pmehrabi/HARE/controller/PCB/20150909_173246.jpg

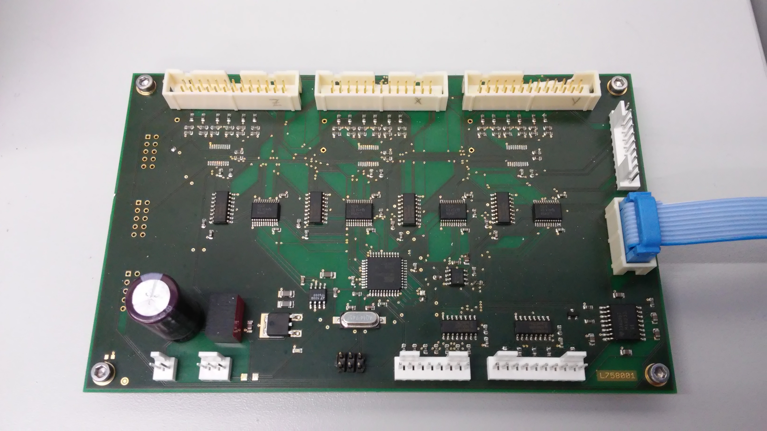
controller/PCB/20150909_173246.jpg
