pmehrabi/HARE/README-Description.md

# HARE

Hardware

PCB layout and schematics: CadSoft EAGLE 7.5.0, now Autodesk

Microcontroller: Atmel Corp, ATxmega128A4U

Firmware programming: Atmel Corp., Atmel Studio 6.2

Delay generator: Stanford Research DG645

Sample positioning: SmarAct GmbH, 3-axes SLC series, controller SDC2-3C-EUR-TAB

GUI

National Instruments LabVIEW 2015, SP1 

Additional Package:

Asynchronous Message Communication (AMC) Library, available at jki.net/vipm

VI Package Manager 2014
