pmehrabi/HARE/controller/cable HD26 to D25/SCBD1508-00-sch.pdf

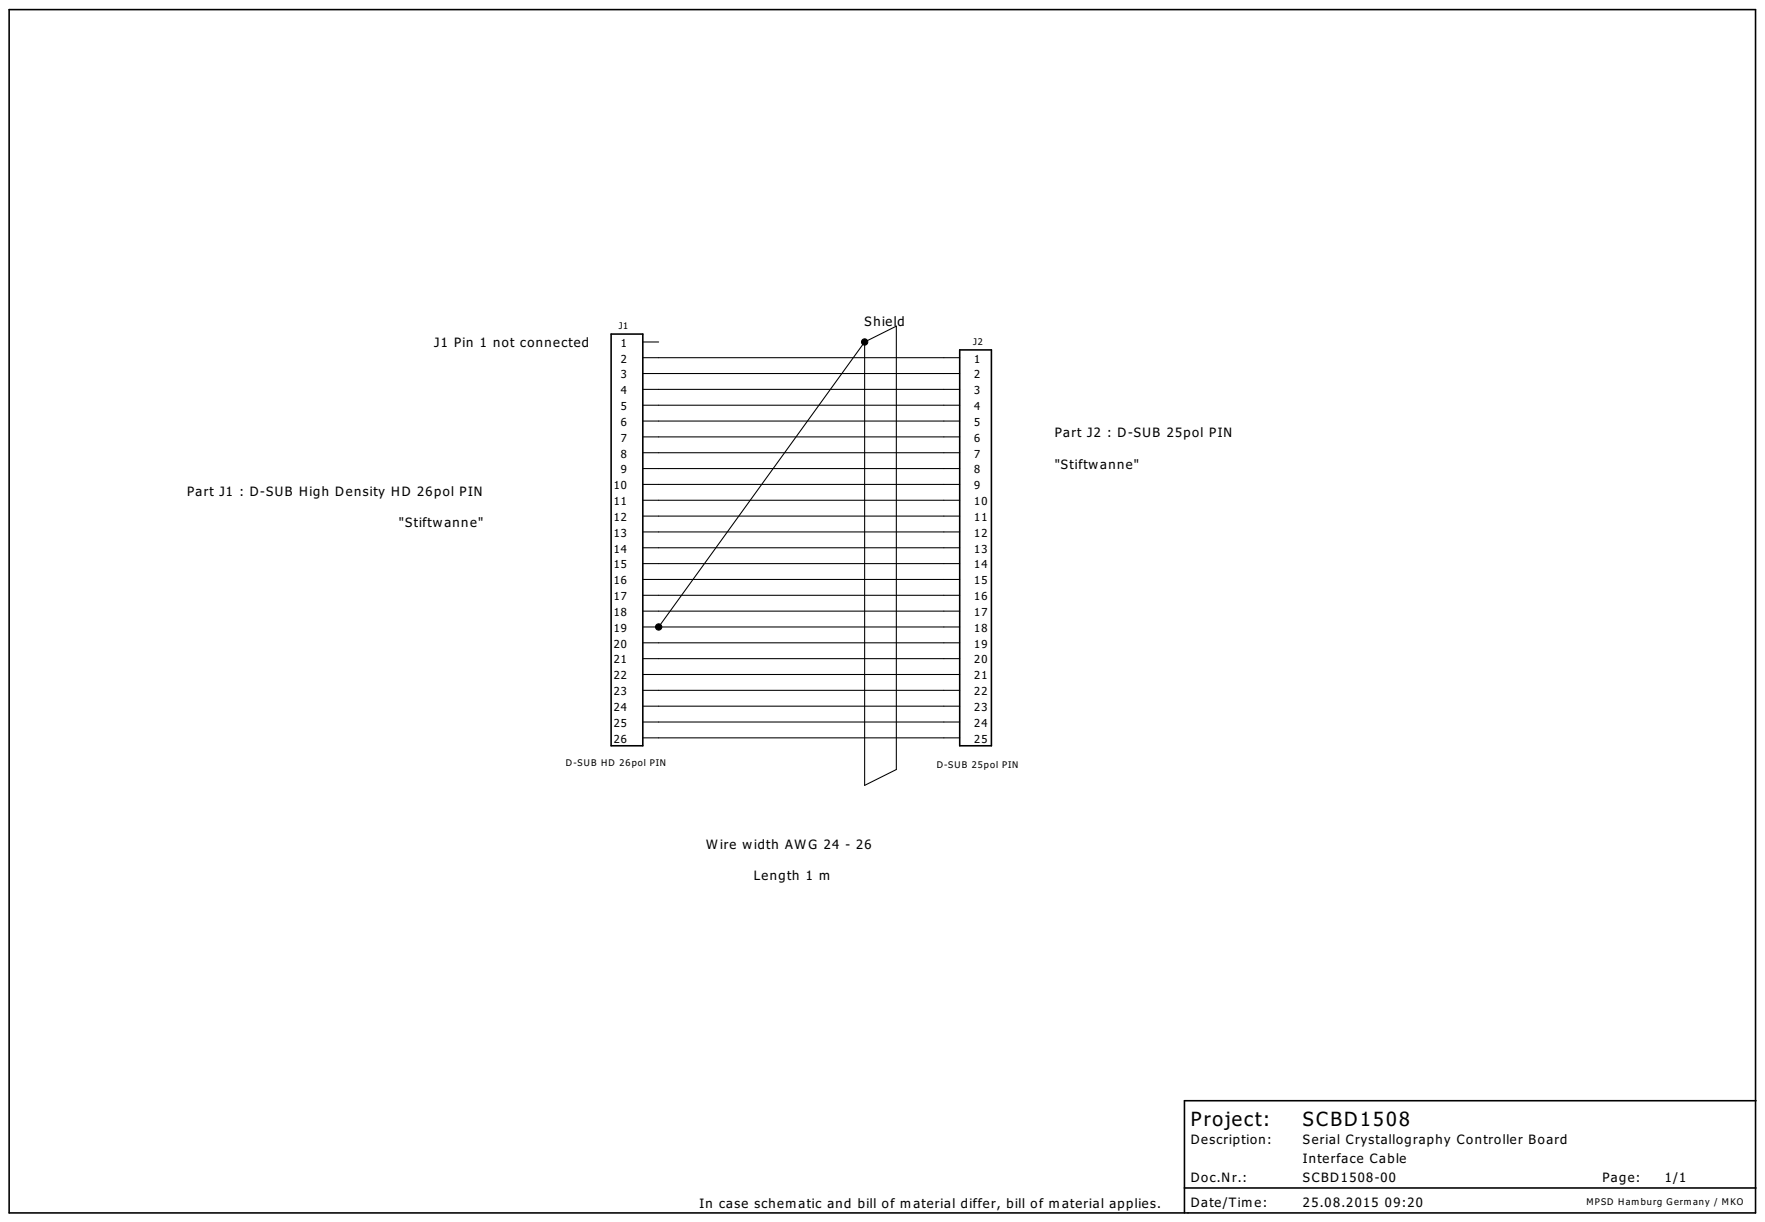
[picture p4: page 1]

Part J1 : D-SUB High Density HD 26pol PIN
