pmehrabi/HARE/controller/PCB/SCCB1508-00-sch.pdf

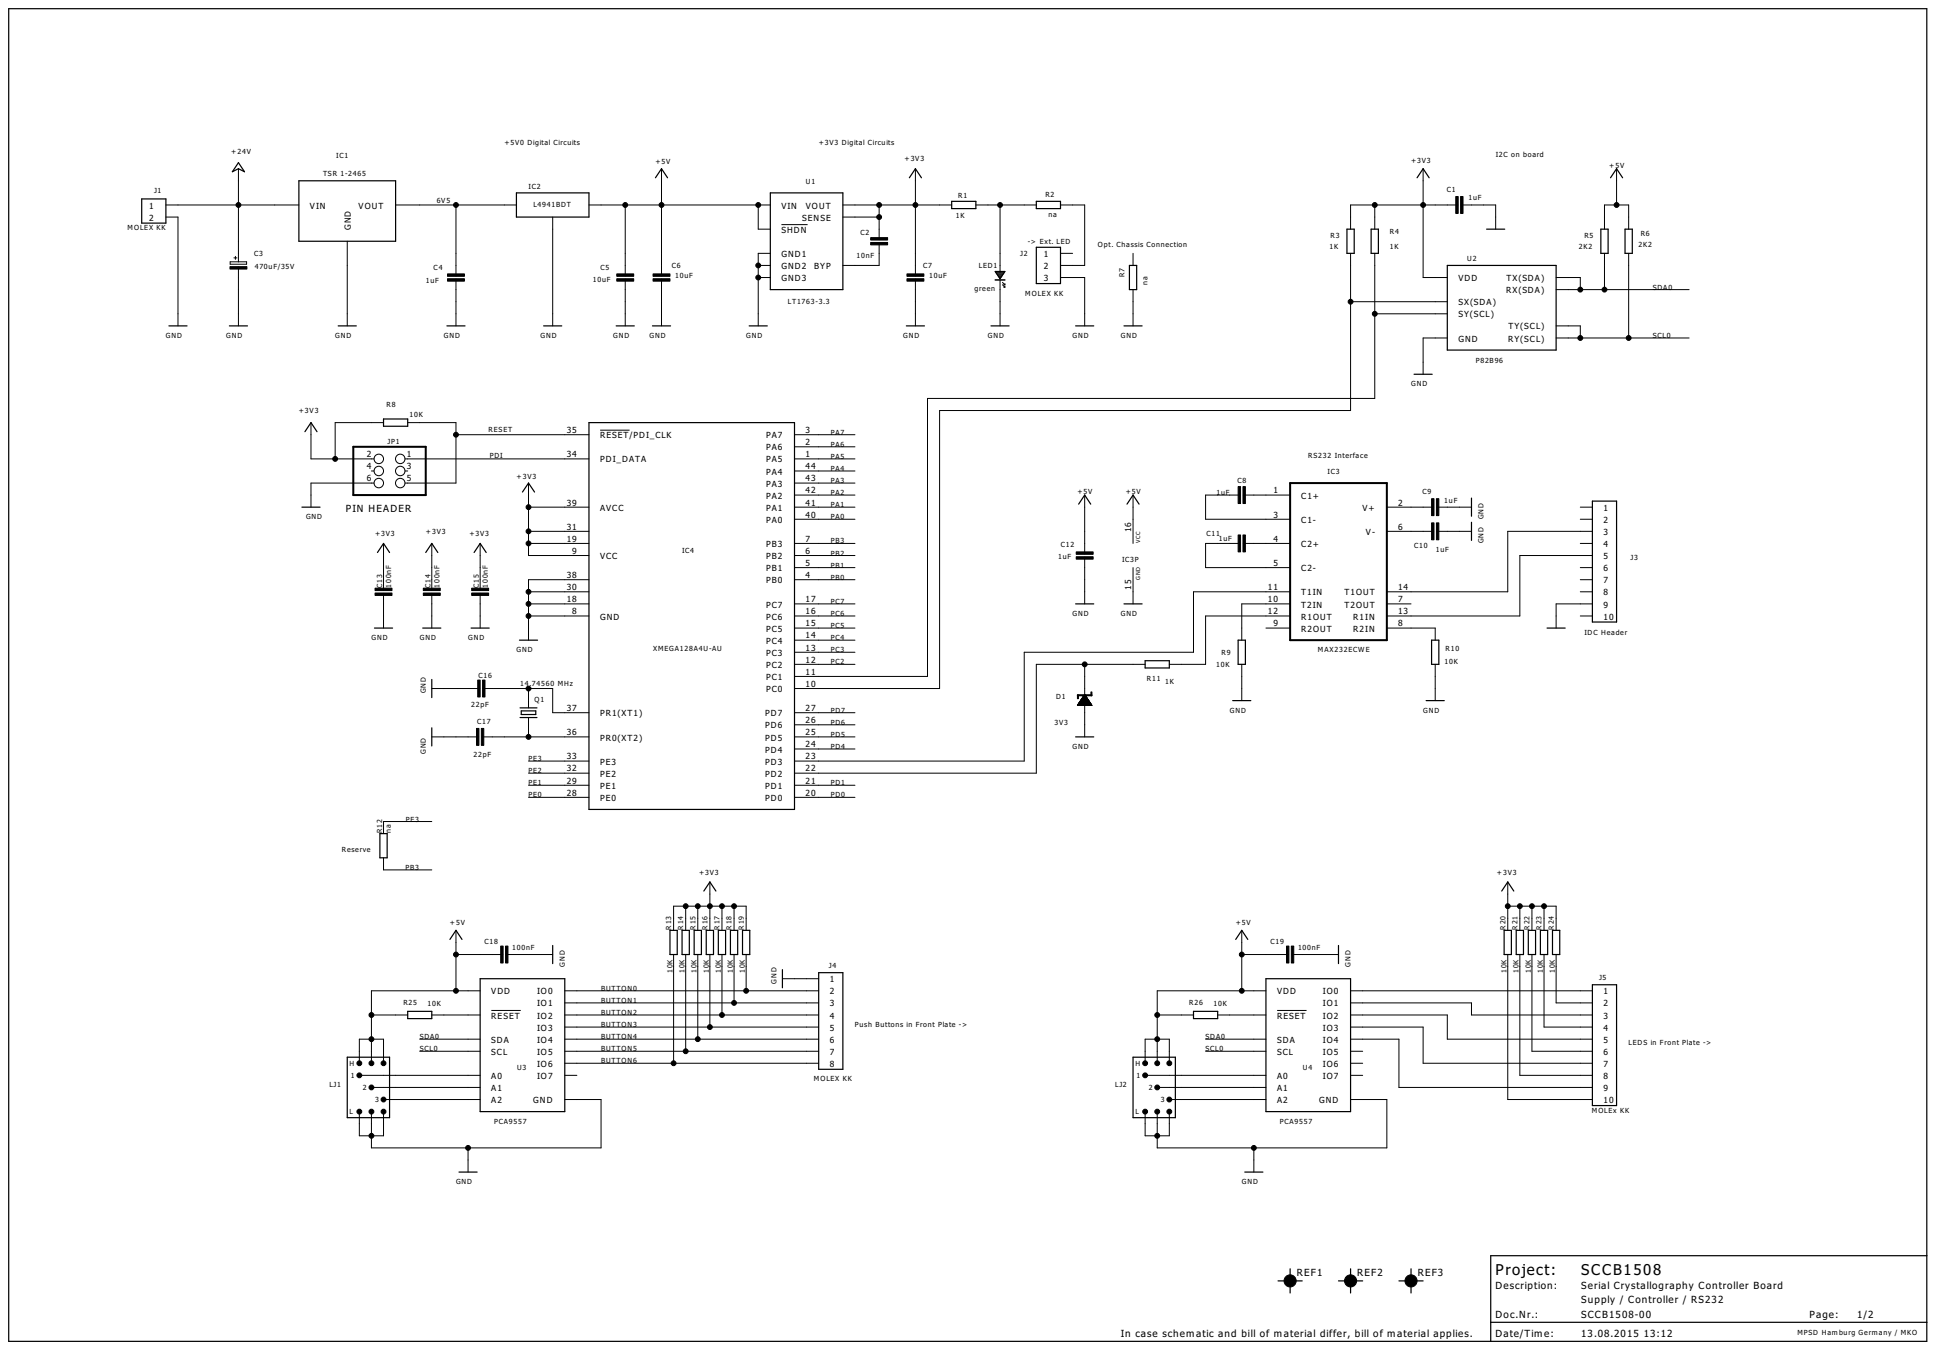
[picture p5: page 1]

Push Buttons in Front Plate ->

LEDS in Front Plate ->

Serial Crystallography Controller Board SCCB1508-00

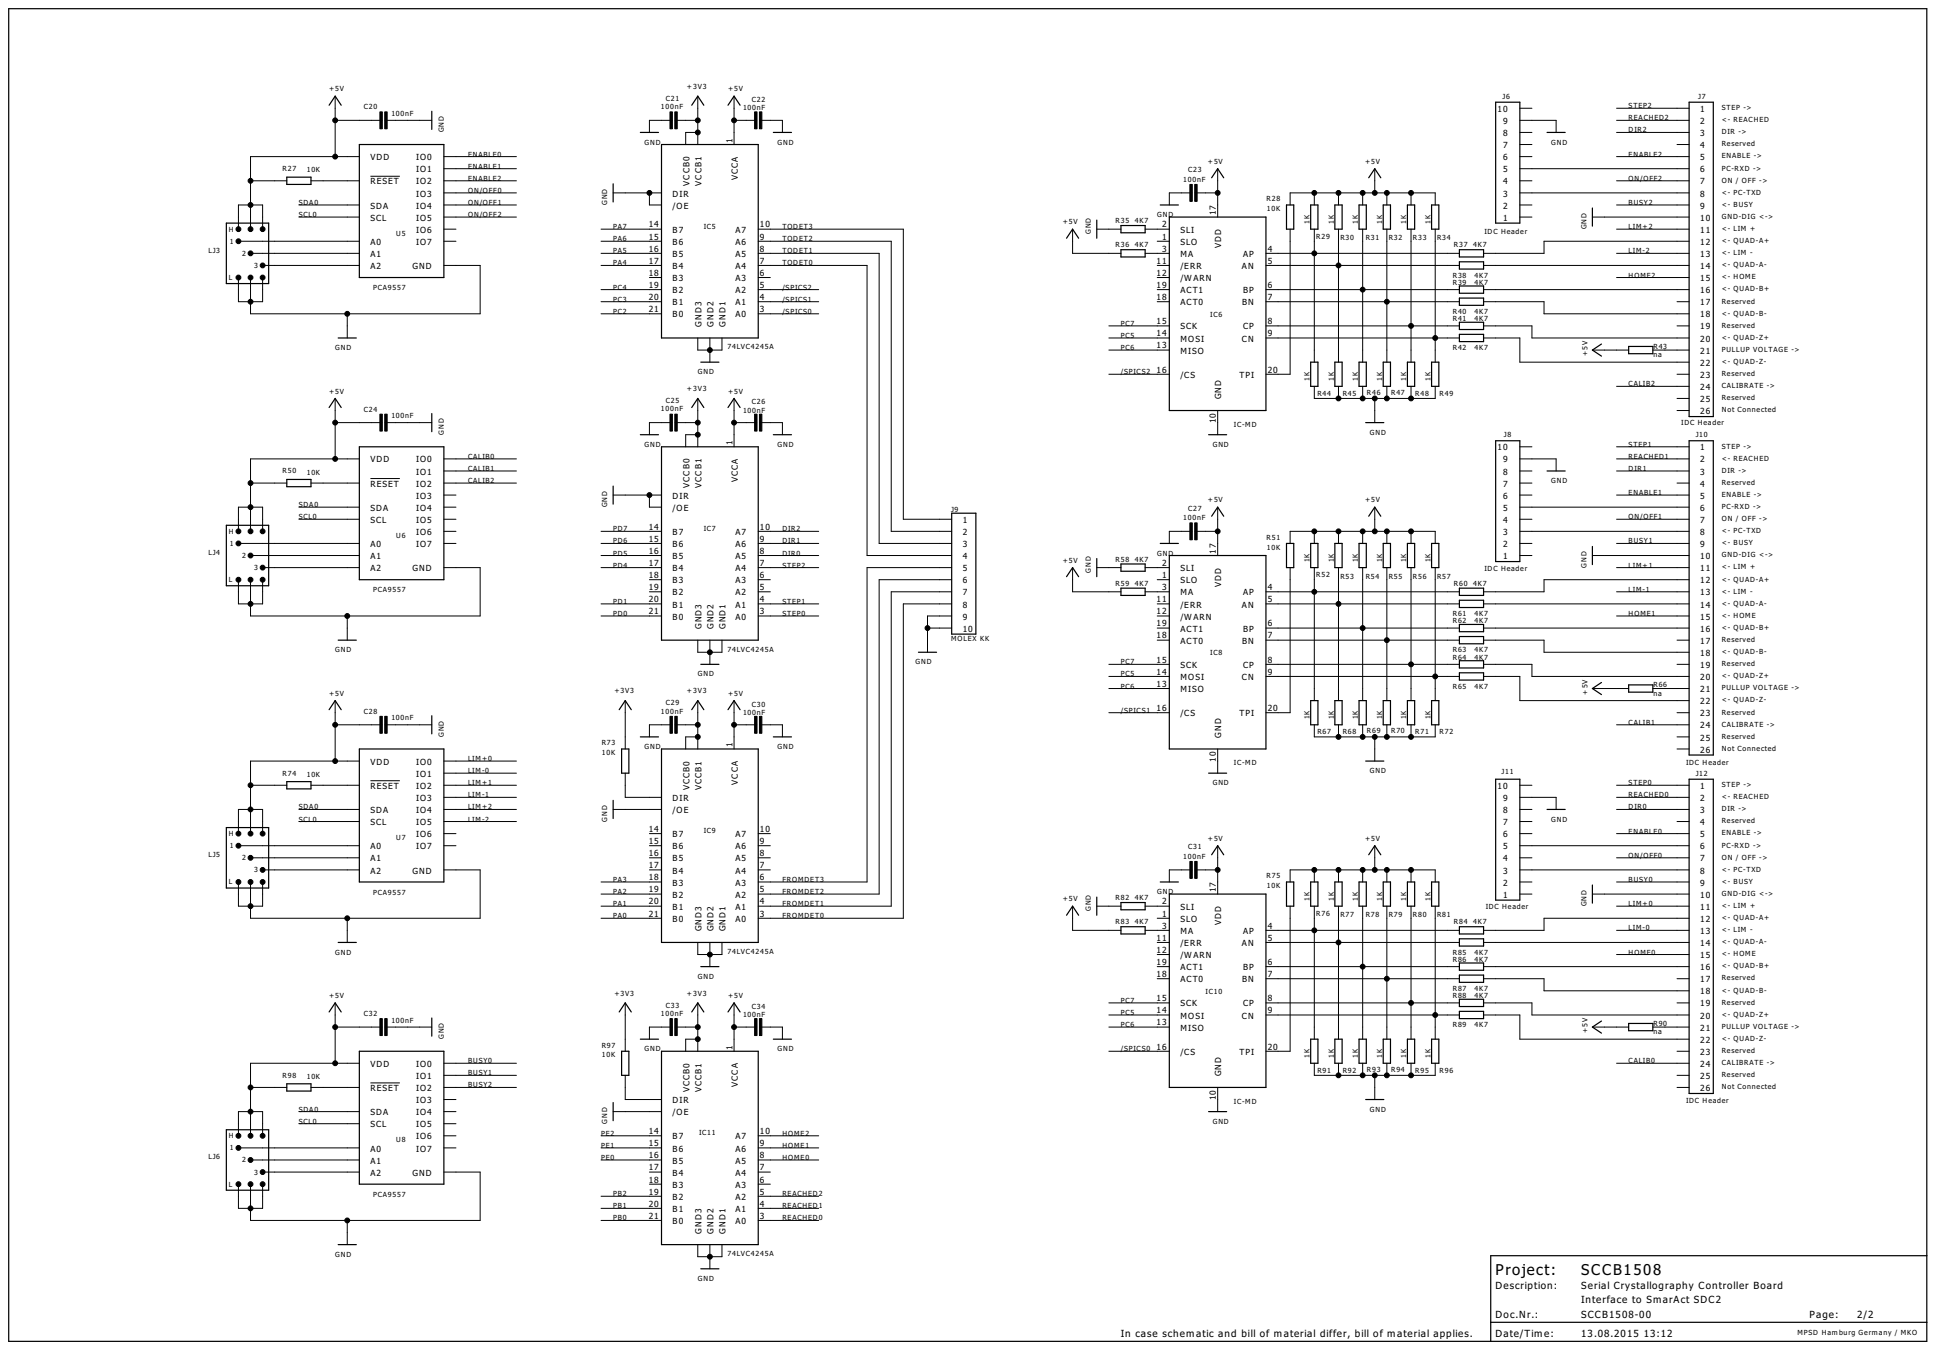
[picture p6: page 2]
