pmehrabi/HARE/controller/PCB/SCCB1508-00-brdo.pdf

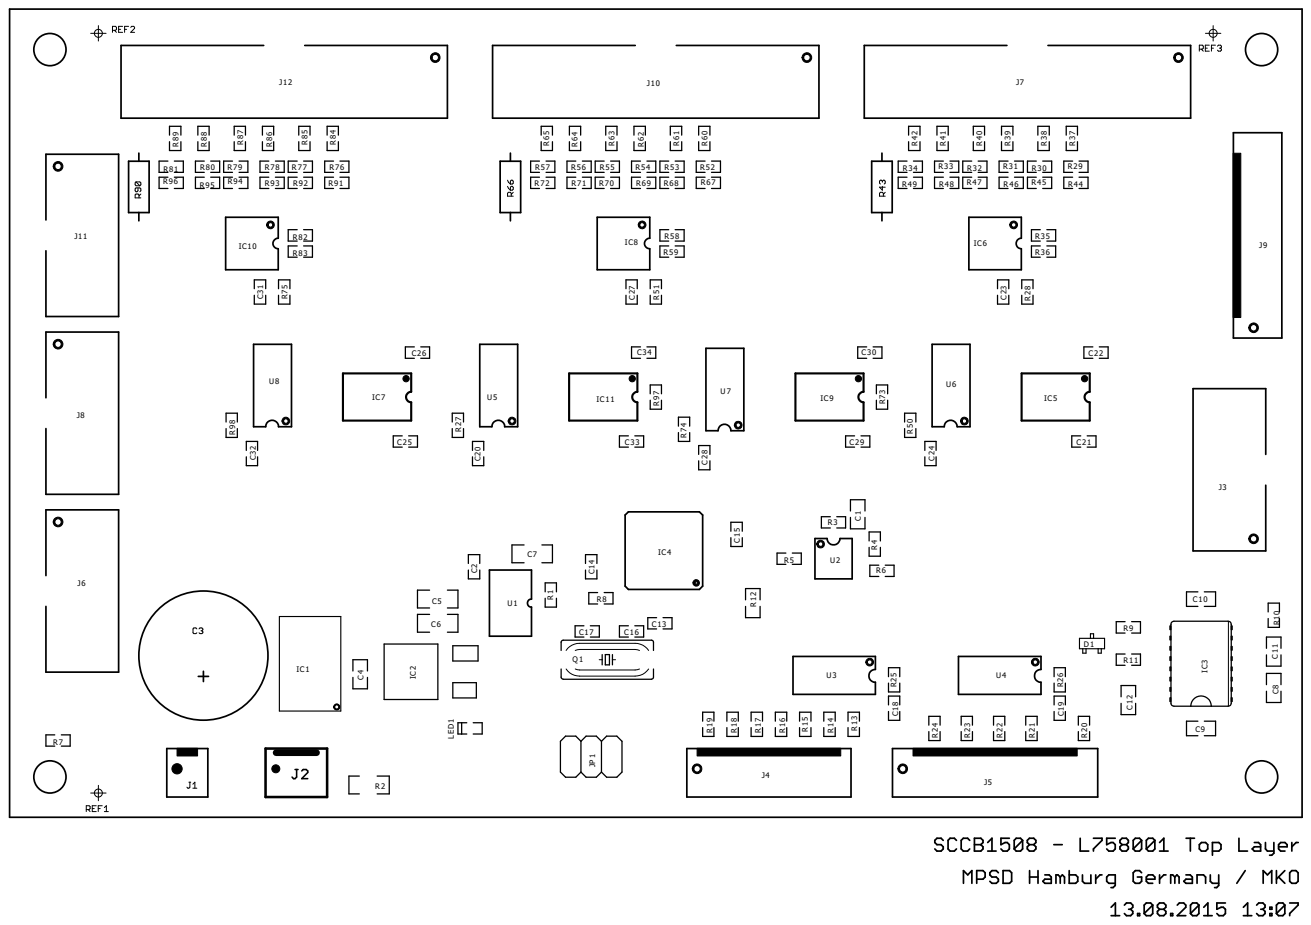
[picture p7: page 1]
