pmehrabi/HARE/controller/PCB/SCCB1508-00.brd

## EAGLE design controller/PCB/SCCB1508-00.brd (2018-08-08)

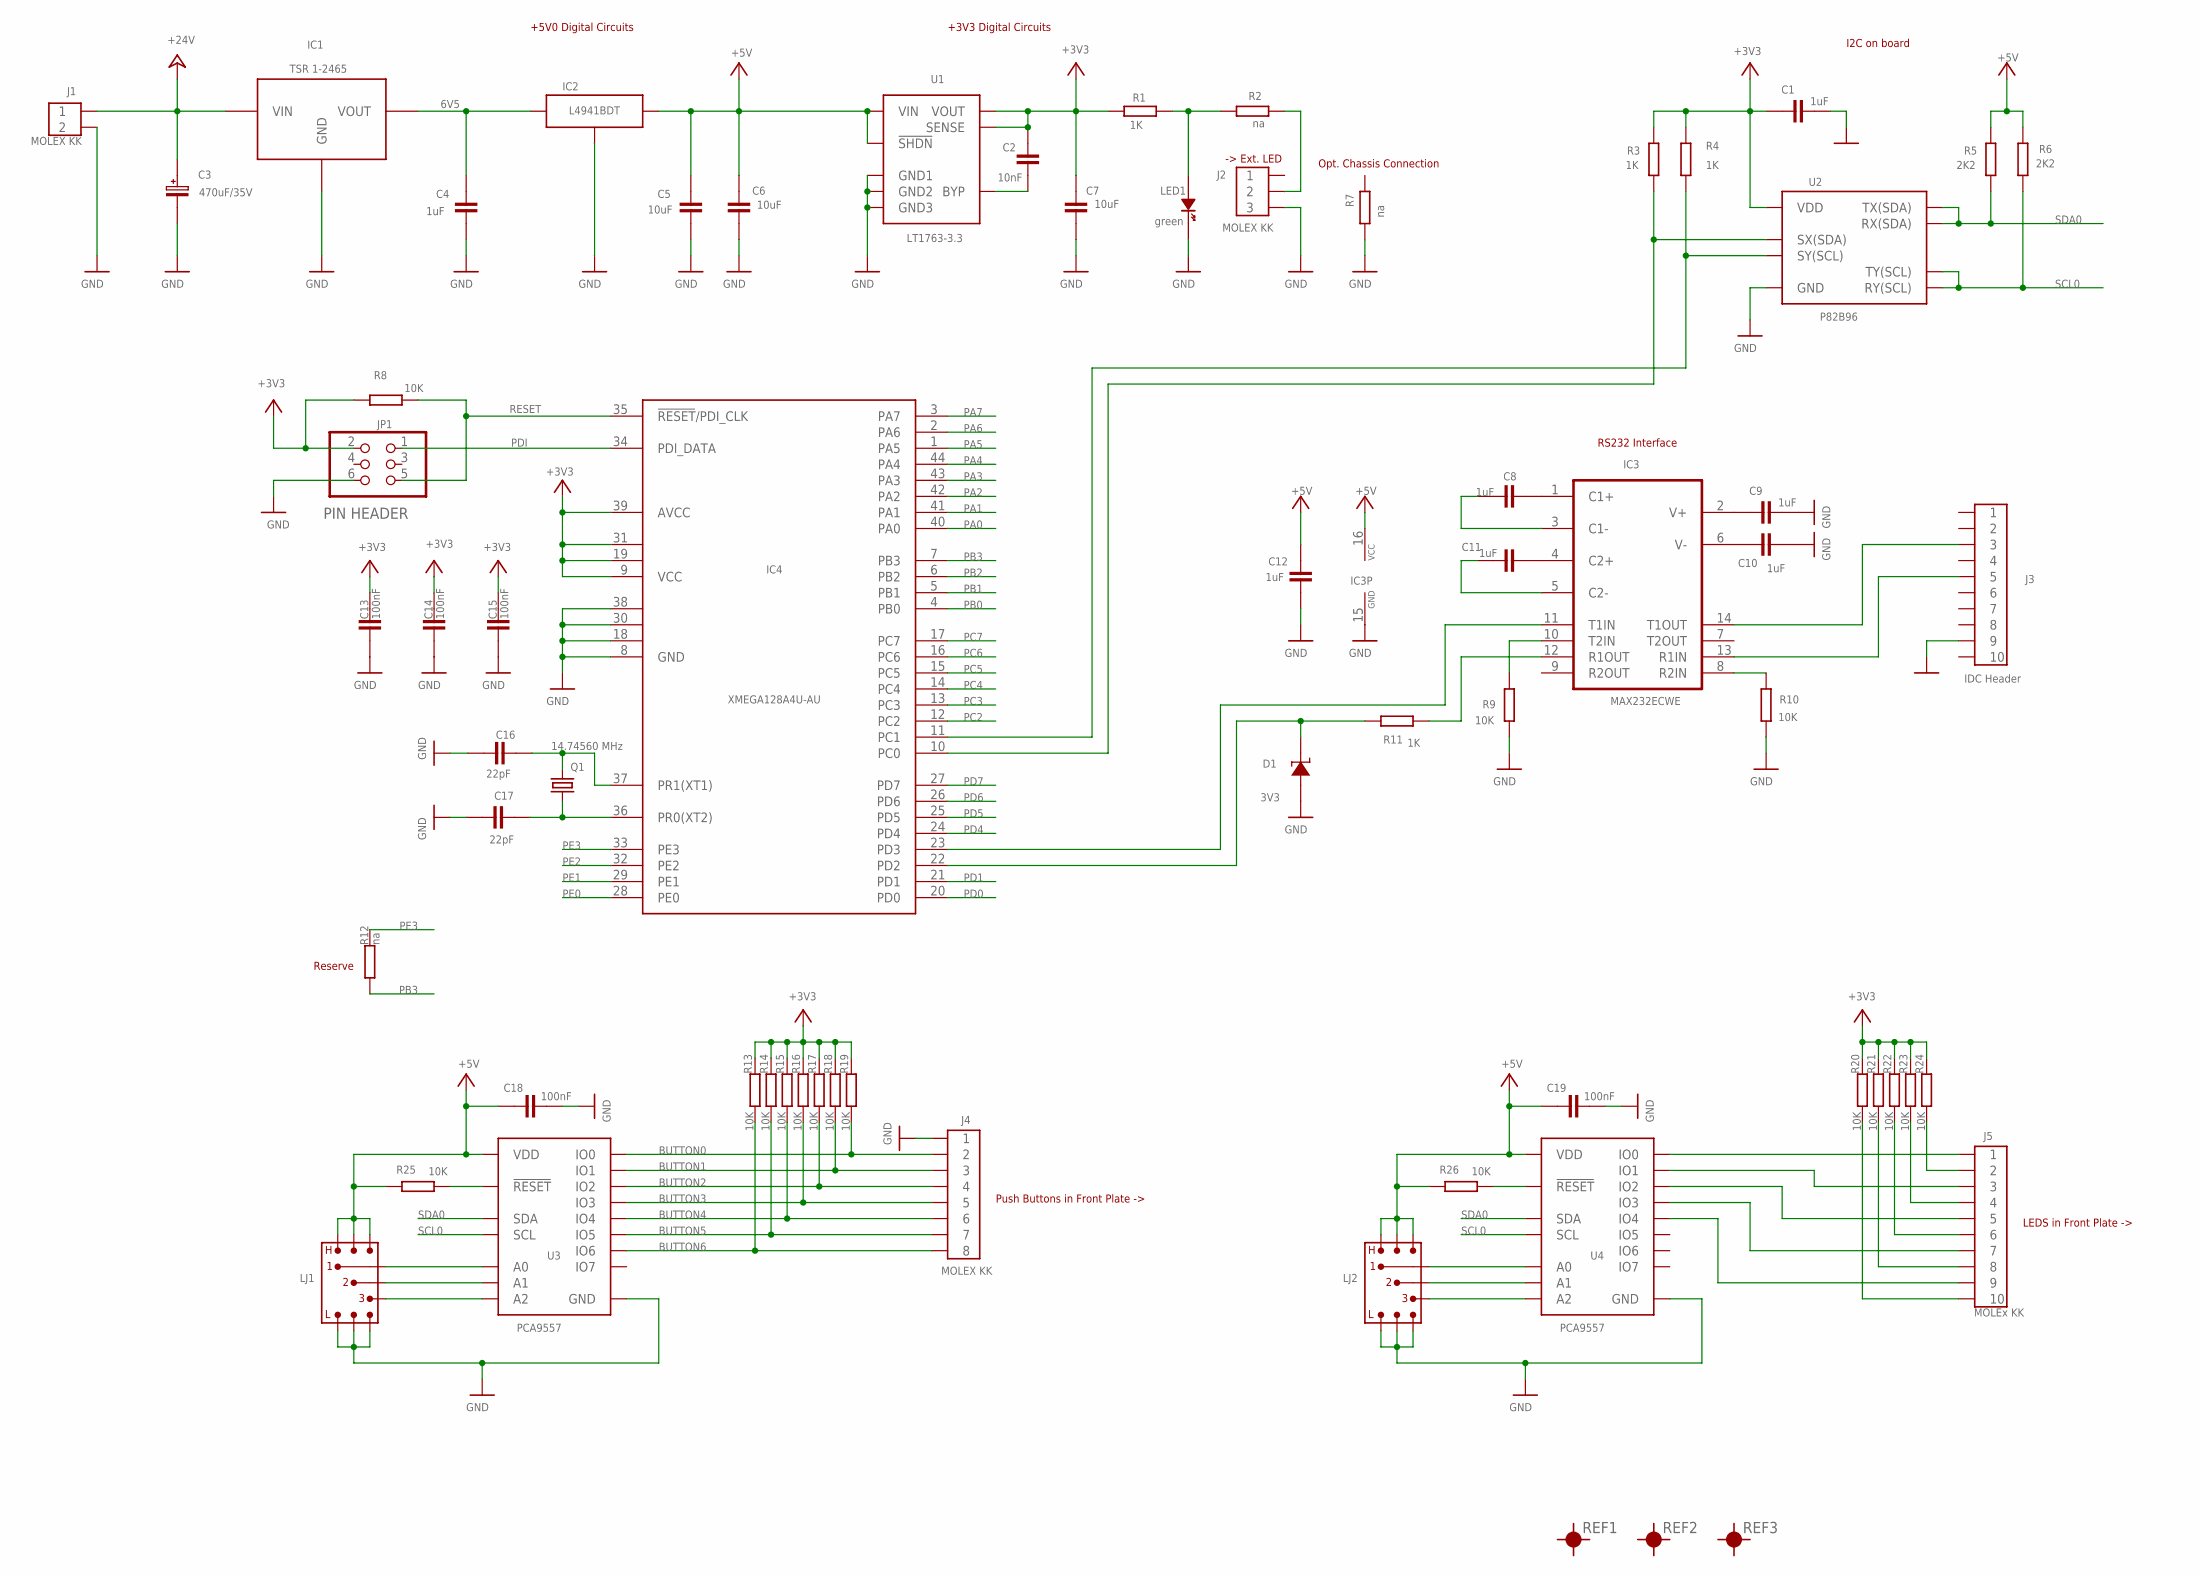
[picture p8: schematic SCCB1508-00.sch, sheet 1]

Parts:
C1, C4, C8, C9, C10, C11, C12: 1uF; 0805
C2: 10nF; 0603
C3: 470uF/35V; C_POL_RM5_D16
C5, C6, C7: 10uF; 1206
C13, C14, C15, C18, C19: 100nF; 0603
C16, C17: 22pF; 0603
D1: 3V3; SOT_23
IC1: TSR 1-2465; TRACO_TSR_1
IC2: L4941BDT; D_PAK
IC3: MAX232ECWE; SO16L
IC4: XMEGA128A4U-AU; TQFP44
J1: MOLEX KK; MOLEX_KK_02POL
J2: MOLEX KK; MOLEX_KK_03POL
J3: IDC Header; IDC_WANNE_10POL
J4: MOLEX KK; MOLEX_KK_08POL
J5: MOLEx KK; MOLEX_KK_10POL
JP1: PIN HEADER; 2X03
LED1: green; 0603_POL
LJ1, LJ2: LOETJUMPER_3KHL_; LOETJUMPER_3KHL
Q1: 14.74560 MHz; HC49UP
R1, R3, R4, R11: 1K; 0603
R2: na; 1206
R5, R6: 2K2; 0603
R7: na; 0603
R8, R9, R10, R13, R14, R15, R16, R17, R18, R19, R20, R21, R22, R23, R24, R25, R26: 10K; 0603
R12: na; 0805
REF1, REF2, REF3: PASSERMARKE_1.0; PASSERMARKE_01
U1: LT1763-3.3; SOIC127P-6-8POL
U2: P82B96; SO_8_BW3.9MM
U3, U4: PCA9557; SO_16_BW3.9MM

Connections:
6V5: C4.2, IC1.P$3 (VOUT), IC2.1 (IN)
+3V3: C1.1, C2.2, C7.2, C13.2, C14.2, C15.2, IC4.9 (VCC), IC4.19 (VCC1), IC4.31 (VCC2), IC4.39 (AVCC), JP1.2, R1.2, R3.1, R4.1, R8.1, R13.1, R14.1, R15.1, R16.1, R17.1, R18.1, R19.1, R20.1, R21.1, R22.1, R23.1, R24.1, U1.1 (VOUT), U1.2 (SENSE), U2.8 (VDD); also elsewhere on the board
+5V: C5.2, C6.2, C12.2, C18.2, C19.2, IC2.3 (OUT), IC3.16 (VCC), LJ1.H1, LJ1.H2, LJ1.H3, LJ2.H1, LJ2.H2, LJ2.H3, R5.1, R6.1, R25.2, R26.2, U1.5 (!SHDN), U1.8 (VIN), U3.16 (VDD), U4.16 (VDD); also elsewhere on the board
+24V: C3.1 (PLUS), IC1.P$1 (VIN), J1.P$1 (1)
BUTTON0: J4.P$2 (2), R19.2, U3.6 (IO0)
BUTTON1: J4.P$3 (3), R18.2, U3.7 (IO1)
BUTTON2: J4.P$4 (4), R17.2, U3.9 (IO2)
BUTTON3: J4.P$5 (5), R16.2, U3.10 (IO3)
BUTTON4: J4.P$6 (6), R15.2, U3.11 (IO4)
BUTTON5: J4.P$7 (7), R14.2, U3.12 (IO5)
BUTTON6: J4.P$8 (8), R13.2, U3.13 (IO6)
GND: C1.2, C3.2 (MINUS), C4.1, C5.1, C6.1, C7.1, C9.2, C10.2, C12.1, C13.1, C14.1, C15.1, C16.1, C17.1, C18.1, C19.1, D1.1 (ANODE), IC1.P$2 (GND), IC2.2 (GND), IC3.15 (GND), IC4.8 (GND), IC4.18 (GND1), IC4.30 (GND2), IC4.38 (GND3), J1.P$2 (2), J2.P$3 (3), J3.9, J4.P$1 (1), JP1.6, LED1.1 (KATHODE), LJ1.L1, LJ1.L2, LJ1.L3, LJ2.L1, LJ2.L2, LJ2.L3, R7.2, R9.1, R10.1, U1.3 (GND1), U1.6 (GND2), U1.7 (GND3), U2.4 (GND), U3.8 (GND), U4.8 (GND); also elsewhere on the board
unnamed: C8.1, IC3.1 (C1+)
unnamed: IC3.14 (T1OUT), J3.3
unnamed: C9.1, IC3.2 (V+)
unnamed: IC3.10 (T2IN), R9.2
unnamed: C10.1, IC3.6 (V-)
unnamed: C11.1, IC3.4 (C2+)
unnamed: C8.2, IC3.3 (C1-)
unnamed: IC3.8 (R2IN), R10.2
unnamed: C11.2, IC3.5 (C2-)
unnamed: C2.1, U1.4 (BYP)
unnamed: LED1.2 (ANODE), R1.1, R2.1
unnamed: J2.P$2 (2), R2.2
unnamed: C16.2, IC4.37 (PR1(XT1)), Q1.1
unnamed: C17.2, IC4.36 (PR0(XT2)), Q1.2
unnamed: IC3.12 (R1OUT), R11.2
unnamed: J5.P$2 (2), R24.2
unnamed: J5.P$4 (4), R23.2
unnamed: J5.P$6 (6), R22.2
unnamed: J5.P$8 (8), R21.2
unnamed: IC3.13 (R1IN), J3.5
unnamed: J5.P$10 (10), R20.2
unnamed: R25.1, U3.15 (!RESET)
unnamed: LJ2.1, U4.3 (A0)
unnamed: LJ2.2, U4.4 (A1)
unnamed: LJ2.3, U4.5 (A2)
unnamed: R26.1, U4.15 (!RESET)
unnamed: LJ1.1, U3.3 (A0)
unnamed: LJ1.2, U3.4 (A1)
unnamed: LJ1.3, U3.5 (A2)
unnamed: IC4.11 (PC1), R4.2, U2.7 (SY(SCL))
unnamed: IC4.10 (PC0), R3.2, U2.1 (SX(SDA))
unnamed: J5.P$1 (1), U4.6 (IO0)
unnamed: J5.P$3 (3), U4.7 (IO1)
unnamed: J5.P$5 (5), U4.9 (IO2)
unnamed: J5.P$7 (7), U4.10 (IO3)
unnamed: J5.P$9 (9), U4.11 (IO4)
PA0: IC4.40 (PA0); also elsewhere on the board
PA1: IC4.41 (PA1); also elsewhere on the board
PA2: IC4.42 (PA2); also elsewhere on the board
PA3: IC4.43 (PA3); also elsewhere on the board
PA4: IC4.44 (PA4); also elsewhere on the board
PA5: IC4.1 (PA5); also elsewhere on the board
PA6: IC4.2 (PA6); also elsewhere on the board
PA7: IC4.3 (PA7); also elsewhere on the board
PB0: IC4.4 (PB0); also elsewhere on the board
PB1: IC4.5 (PB1); also elsewhere on the board
PB2: IC4.6 (PB2); also elsewhere on the board
PB3: IC4.7 (PB3), R12.1
PC2: IC4.12 (PC2); also elsewhere on the board
PC3: IC4.13 (PC3); also elsewhere on the board
PC4: IC4.14 (PC4); also elsewhere on the board
PC5: IC4.15 (PC5); also elsewhere on the board
PC6: IC4.16 (PC6); also elsewhere on the board
PC7: IC4.17 (PC7); also elsewhere on the board
PD0: IC4.20 (PD0); also elsewhere on the board
PD1: IC4.21 (PD1); also elsewhere on the board
PD4: IC4.24 (PD4); also elsewhere on the board
PD5: IC4.25 (PD5); also elsewhere on the board
PD6: IC4.26 (PD6); also elsewhere on the board
PD7: IC4.27 (PD7); also elsewhere on the board
PDI: IC4.34 (PDI_DATA), JP1.1
PE0: IC4.28 (PE0); also elsewhere on the board
PE1: IC4.29 (PE1); also elsewhere on the board
PE2: IC4.32 (PE2); also elsewhere on the board
PE3: IC4.33 (PE3), R12.2
RESET: IC4.35 (!RESET!/PDI_CLK), JP1.5, R8.2
RX0: D1.3 (KATHODE), IC4.22 (PD2), R11.1
SCL0: R6.2, U2.5 (TY(SCL)), U2.6 (RY(SCL)), U3.1 (SCL), U4.1 (SCL); also elsewhere on the board
SDA0: R5.2, U2.2 (RX(SDA)), U2.3 (TX(SDA)), U3.2 (SDA), U4.2 (SDA); also elsewhere on the board
TX0: IC3.11 (T1IN), IC4.23 (PD3)

Notes on the sheet:
RS232 Interface
+3V3 Digital Circuits
+5V0 Digital Circuits
-> Ext. LED
Push Buttons in Front Plate ->
LEDS in Front Plate ->
I2C on board
Reserve
Opt. Chassis Connection

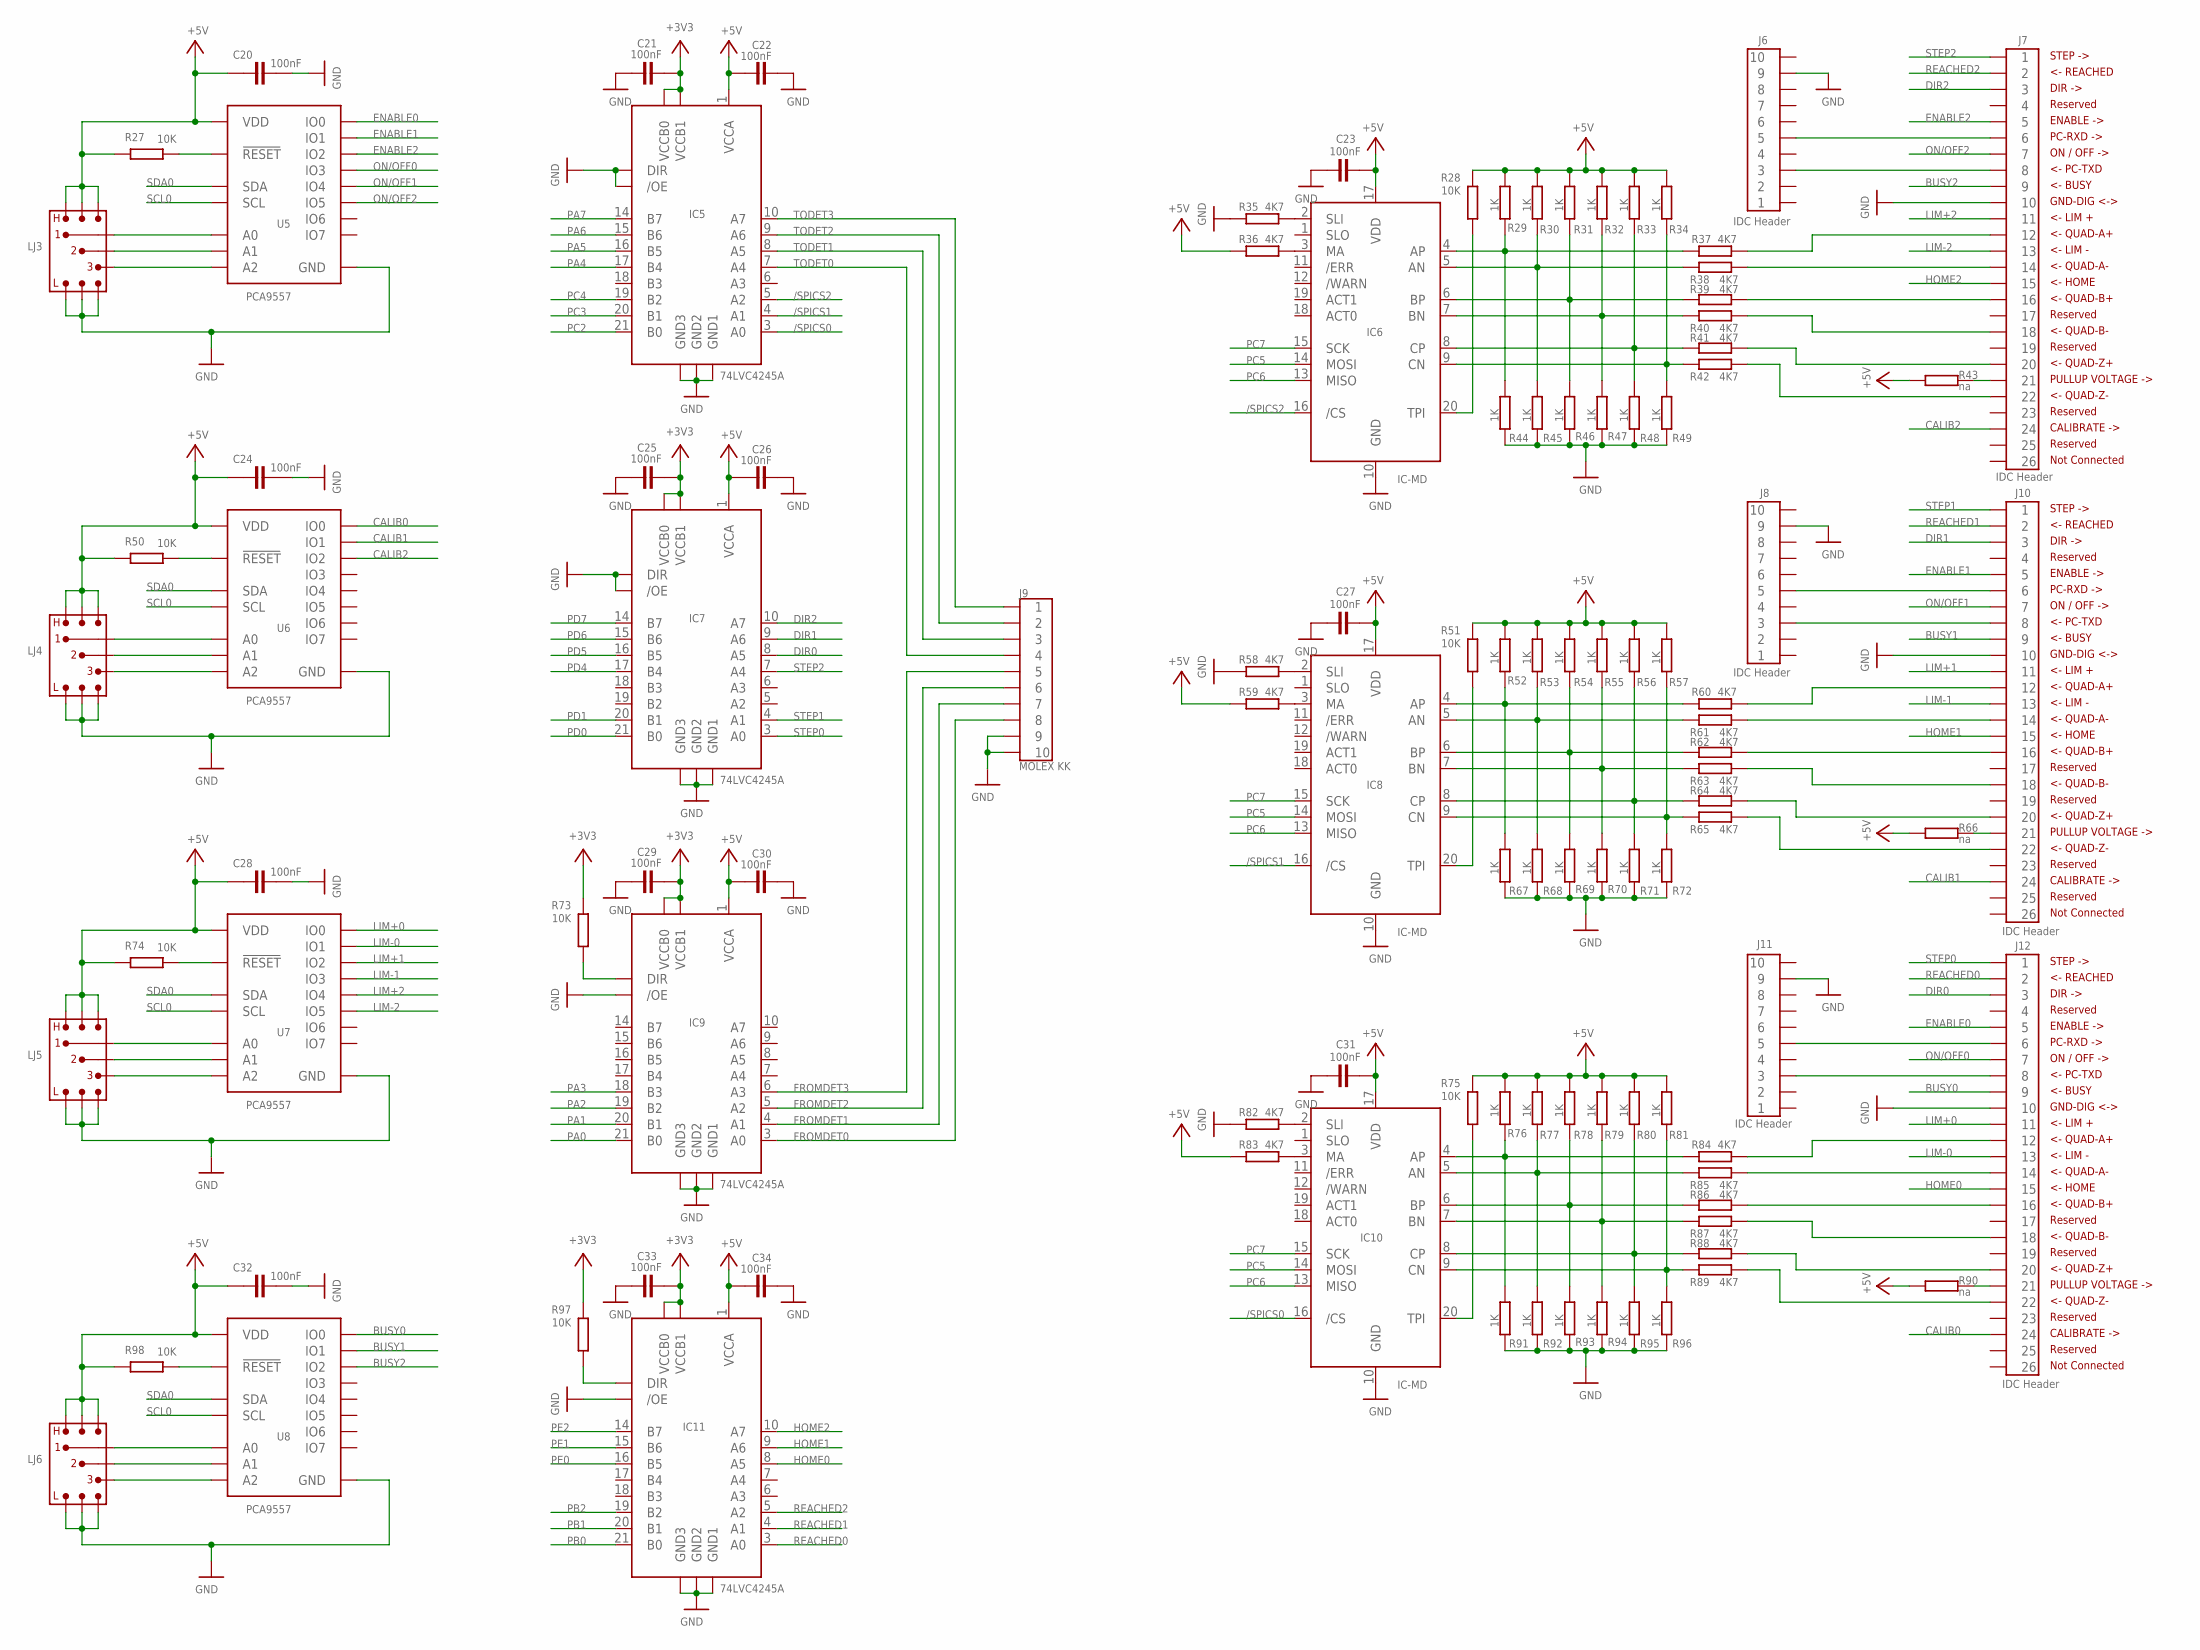
[picture p9: schematic SCCB1508-00.sch, sheet 2]

Parts:
C20, C21, C22, C23, C24, C25, C26, C27, C28, C29, C30, C31, C32, C33, C34: 100nF; 0603
IC5, IC7, IC9, IC11: 74LVC4245A; SO_24_BW5.3MM
IC6, IC8, IC10: IC-MD; SSOP_20_BW4.4
J6, J8, J11: IDC Header; IDC_WANNE_10POL
J7, J10, J12: IDC Header; IDC_WANNE_26POL
J9: MOLEX KK; MOLEX_KK_10POL
LJ3, LJ4, LJ5, LJ6: LOETJUMPER_3KHL_; LOETJUMPER_3KHL
R27, R28, R50, R51, R73, R74, R75, R97, R98: 10K; 0603
R29, R30, R31, R32, R33, R34, R44, R45, R46, R47, R48, R49, R52, R53, R54, R55, R56, R57, R67, R68, R69, R70, R71, R72, R76, R77, R78, R79, R80, R81, R91, R92, R93, R94, R95, R96: 1K; 0603
R35, R36, R37, R38, R39, R40, R41, R42, R58, R59, R60, R61, R62, R63, R64, R65, R82, R83, R84, R85, R86, R87, R88, R89: 4K7; 0603
R43, R66, R90: na; RM10L10B2.5
U5, U6, U7, U8: PCA9557; SO_16_BW3.9MM

Connections:
+3V3: C21.1, C25.1, C29.1, C33.1, IC5.23 (VCCB0), IC5.24 (VCCB1), IC7.23 (VCCB0), IC7.24 (VCCB1), IC9.23 (VCCB0), IC9.24 (VCCB1), IC11.23 (VCCB0), IC11.24 (VCCB1), R73.1, R97.1; also elsewhere on the board
+5V: C20.2, C22.2, C23.2, C24.2, C26.2, C27.2, C28.2, C30.2, C31.2, C32.2, C34.2, IC5.1 (VCCA), IC6.17 (VDD), IC7.1 (VCCA), IC8.17 (VDD), IC9.1 (VCCA), IC10.17 (VDD), IC11.1 (VCCA), LJ3.H1, LJ3.H2, LJ3.H3, LJ4.H1, LJ4.H2, LJ4.H3, LJ5.H1, LJ5.H2, LJ5.H3, LJ6.H1, LJ6.H2, LJ6.H3, R27.2, R28.1, R29.2, R30.2, R31.2, R32.2, R33.2, R34.2, R36.1, R43.1, R50.2, R51.1, R52.2, R53.2, R54.2, R55.2, R56.2, R57.2, R59.1, R66.1, R74.2, R75.1, R76.2, R77.2, R78.2, R79.2, R80.2, R81.2, R83.1, R90.1, R98.2, U5.16 (VDD), U6.16 (VDD), U7.16 (VDD), U8.16 (VDD); also elsewhere on the board
/SPICS0: IC5.3 (A0), IC10.16 (/CS)
/SPICS1: IC5.4 (A1), IC8.16 (/CS)
/SPICS2: IC5.5 (A2), IC6.16 (/CS)
BUSY0: J12.9, U8.6 (IO0)
BUSY1: J10.9, U8.7 (IO1)
BUSY2: J7.9, U8.9 (IO2)
CALIB0: J12.24, U6.6 (IO0)
CALIB1: J10.24, U6.7 (IO1)
CALIB2: J7.24, U6.9 (IO2)
DIR0: IC7.8 (A5), J12.3
DIR1: IC7.9 (A6), J10.3
DIR2: IC7.10 (A7), J7.3
ENABLE0: J12.5, U5.6 (IO0)
ENABLE1: J10.5, U5.7 (IO1)
ENABLE2: J7.5, U5.9 (IO2)
FROMDET0: IC9.3 (A0), J9.P$8 (8)
FROMDET1: IC9.4 (A1), J9.P$7 (7)
FROMDET2: IC9.5 (A2), J9.P$6 (6)
FROMDET3: IC9.6 (A3), J9.P$5 (5)
GND: C20.1, C21.2, C22.1, C23.1, C24.1, C25.2, C26.1, C27.1, C28.1, C29.2, C30.1, C31.1, C32.1, C33.2, C34.1, IC5.2 (DIR), IC5.11 (GND1), IC5.12 (GND2), IC5.13 (GND3), IC5.22 (/OE), IC6.10 (GND), IC7.2 (DIR), IC7.11 (GND1), IC7.12 (GND2), IC7.13 (GND3), IC7.22 (/OE), IC8.10 (GND), IC9.11 (GND1), IC9.12 (GND2), IC9.13 (GND3), IC9.22 (/OE), IC10.10 (GND), IC11.11 (GND1), IC11.12 (GND2), IC11.13 (GND3), IC11.22 (/OE), J6.9, J7.10, J8.9, J9.P$9 (9), J9.P$10 (10), J10.10, J11.9, J12.10, LJ3.L1, LJ3.L2, LJ3.L3, LJ4.L1, LJ4.L2, LJ4.L3, LJ5.L1, LJ5.L2, LJ5.L3, LJ6.L1, LJ6.L2, LJ6.L3, R35.1, R44.1, R45.1, R46.1, R47.1, R48.1, R49.1, R58.1, R67.1, R68.1, R69.1, R70.1, R71.1, R72.1, R82.1, R91.1, R92.1, R93.1, R94.1, R95.1, R96.1, U5.8 (GND), U6.8 (GND), U7.8 (GND), U8.8 (GND); also elsewhere on the board
HOME0: IC11.8 (A5), J12.15
HOME1: IC11.9 (A6), J10.15
HOME2: IC11.10 (A7), J7.15
LIM+0: J12.11, U7.6 (IO0)
LIM+1: J10.11, U7.9 (IO2)
LIM+2: J7.11, U7.11 (IO4)
LIM-0: J12.13, U7.7 (IO1)
LIM-1: J10.13, U7.10 (IO3)
LIM-2: J7.13, U7.12 (IO5)
unnamed: J6.3, J7.8
unnamed: J6.5, J7.6
unnamed: IC6.20 (TPI), R28.2
unnamed: IC6.9 (CN), R34.1, R42.1, R49.2
unnamed: IC6.8 (CP), R33.1, R41.1, R48.2
unnamed: IC6.7 (BN), R32.1, R40.1, R47.2
unnamed: IC6.6 (BP), R31.1, R39.1, R46.2
unnamed: IC6.5 (AN), R30.1, R38.1, R45.2
unnamed: IC6.4 (AP), R29.1, R37.1, R44.2
unnamed: IC6.3 (MA), R36.2
unnamed: IC6.2 (SLI), R35.2
unnamed: J7.12, R37.2
unnamed: J7.14, R38.2
unnamed: J7.16, R39.2
unnamed: J7.18, R40.2
unnamed: J7.20, R41.2
unnamed: J7.22, R42.2
unnamed: IC9.2 (DIR), R73.2
unnamed: IC11.2 (DIR), R97.2
unnamed: LJ5.1, U7.3 (A0)
unnamed: LJ5.2, U7.4 (A1)
unnamed: J7.21, R43.2
unnamed: LJ5.3, U7.5 (A2)
unnamed: R74.1, U7.15 (!RESET)
unnamed: LJ3.1, U5.3 (A0)
unnamed: LJ3.2, U5.4 (A1)
unnamed: LJ3.3, U5.5 (A2)
unnamed: R27.1, U5.15 (!RESET)
unnamed: LJ4.1, U6.3 (A0)
unnamed: LJ4.2, U6.4 (A1)
unnamed: LJ4.3, U6.5 (A2)
unnamed: R50.1, U6.15 (!RESET)
unnamed: LJ6.1, U8.3 (A0)
unnamed: LJ6.2, U8.4 (A1)
unnamed: LJ6.3, U8.5 (A2)
unnamed: R98.1, U8.15 (!RESET)
unnamed: J8.3, J10.8
unnamed: J8.5, J10.6
unnamed: IC8.9 (CN), R57.1, R65.1, R72.2
unnamed: IC8.8 (CP), R56.1, R64.1, R71.2
unnamed: IC8.7 (BN), R55.1, R63.1, R70.2
unnamed: IC8.6 (BP), R54.1, R62.1, R69.2
unnamed: IC8.5 (AN), R53.1, R61.1, R68.2
unnamed: IC8.4 (AP), R52.1, R60.1, R67.2
unnamed: IC8.20 (TPI), R51.2
unnamed: IC8.3 (MA), R59.2
unnamed: IC8.2 (SLI), R58.2
unnamed: J10.12, R60.2
unnamed: J10.14, R61.2
unnamed: J10.16, R62.2
unnamed: J10.18, R63.2
unnamed: J10.20, R64.2
unnamed: J10.22, R65.2
unnamed: J10.21, R66.2
unnamed: J11.3, J12.8
unnamed: J11.5, J12.6
unnamed: IC10.9 (CN), R81.1, R89.1, R96.2
unnamed: IC10.8 (CP), R80.1, R88.1, R95.2
unnamed: IC10.7 (BN), R79.1, R87.1, R94.2
unnamed: IC10.6 (BP), R78.1, R86.1, R93.2
unnamed: IC10.5 (AN), R77.1, R85.1, R92.2
unnamed: IC10.4 (AP), R76.1, R84.1, R91.2
unnamed: IC10.20 (TPI), R75.2
unnamed: IC10.3 (MA), R83.2
unnamed: IC10.2 (SLI), R82.2
unnamed: J12.12, R84.2
unnamed: J12.14, R85.2
unnamed: J12.16, R86.2
unnamed: J12.18, R87.2
unnamed: J12.20, R88.2
unnamed: J12.22, R89.2
unnamed: J12.21, R90.2
ON/OFF0: J12.7, U5.10 (IO3)
ON/OFF1: J10.7, U5.11 (IO4)
ON/OFF2: J7.7, U5.12 (IO5)
PA0: IC9.21 (B0); also elsewhere on the board
PA1: IC9.20 (B1); also elsewhere on the board
PA2: IC9.19 (B2); also elsewhere on the board
PA3: IC9.18 (B3); also elsewhere on the board
PA4: IC5.17 (B4); also elsewhere on the board
PA5: IC5.16 (B5); also elsewhere on the board
PA6: IC5.15 (B6); also elsewhere on the board
PA7: IC5.14 (B7); also elsewhere on the board
PB0: IC11.21 (B0); also elsewhere on the board
PB1: IC11.20 (B1); also elsewhere on the board
PB2: IC11.19 (B2); also elsewhere on the board
PC2: IC5.21 (B0); also elsewhere on the board
PC3: IC5.20 (B1); also elsewhere on the board
PC4: IC5.19 (B2); also elsewhere on the board
PC5: IC6.14 (MOSI), IC8.14 (MOSI), IC10.14 (MOSI); also elsewhere on the board
PC6: IC6.13 (MISO), IC8.13 (MISO), IC10.13 (MISO); also elsewhere on the board
PC7: IC6.15 (SCK), IC8.15 (SCK), IC10.15 (SCK); also elsewhere on the board
PD0: IC7.21 (B0); also elsewhere on the board
PD1: IC7.20 (B1); also elsewhere on the board
PD4: IC7.17 (B4); also elsewhere on the board
PD5: IC7.16 (B5); also elsewhere on the board
PD6: IC7.15 (B6); also elsewhere on the board
PD7: IC7.14 (B7); also elsewhere on the board
PE0: IC11.16 (B5); also elsewhere on the board
PE1: IC11.15 (B6); also elsewhere on the board
PE2: IC11.14 (B7); also elsewhere on the board
REACHED0: IC11.3 (A0), J12.2
REACHED1: IC11.4 (A1), J10.2
REACHED2: IC11.5 (A2), J7.2
SCL0: U5.1 (SCL), U6.1 (SCL), U7.1 (SCL), U8.1 (SCL); also elsewhere on the board
SDA0: U5.2 (SDA), U6.2 (SDA), U7.2 (SDA), U8.2 (SDA); also elsewhere on the board
STEP0: IC7.3 (A0), J12.1
STEP1: IC7.4 (A1), J10.1
STEP2: IC7.7 (A4), J7.1
TODET0: IC5.7 (A4), J9.P$4 (4)
TODET1: IC5.8 (A5), J9.P$3 (3)
TODET2: IC5.9 (A6), J9.P$2 (2)
TODET3: IC5.10 (A7), J9.P$1 (1)

Notes on the sheet:
GND-DIG <->
STEP ->
DIR ->
ENABLE ->
ON / OFF ->
<- BUSY
<- LIM +
<- LIM -
<- HOME
Reserved
PULLUP VOLTAGE ->
<- REACHED
PC-RXD ->
<- PC-TXD
<- QUAD-A+
<- QUAD-A-
<- QUAD-B+
<- QUAD-B-
<- QUAD-Z+
<- QUAD-Z-
CALIBRATE ->
Not Connected

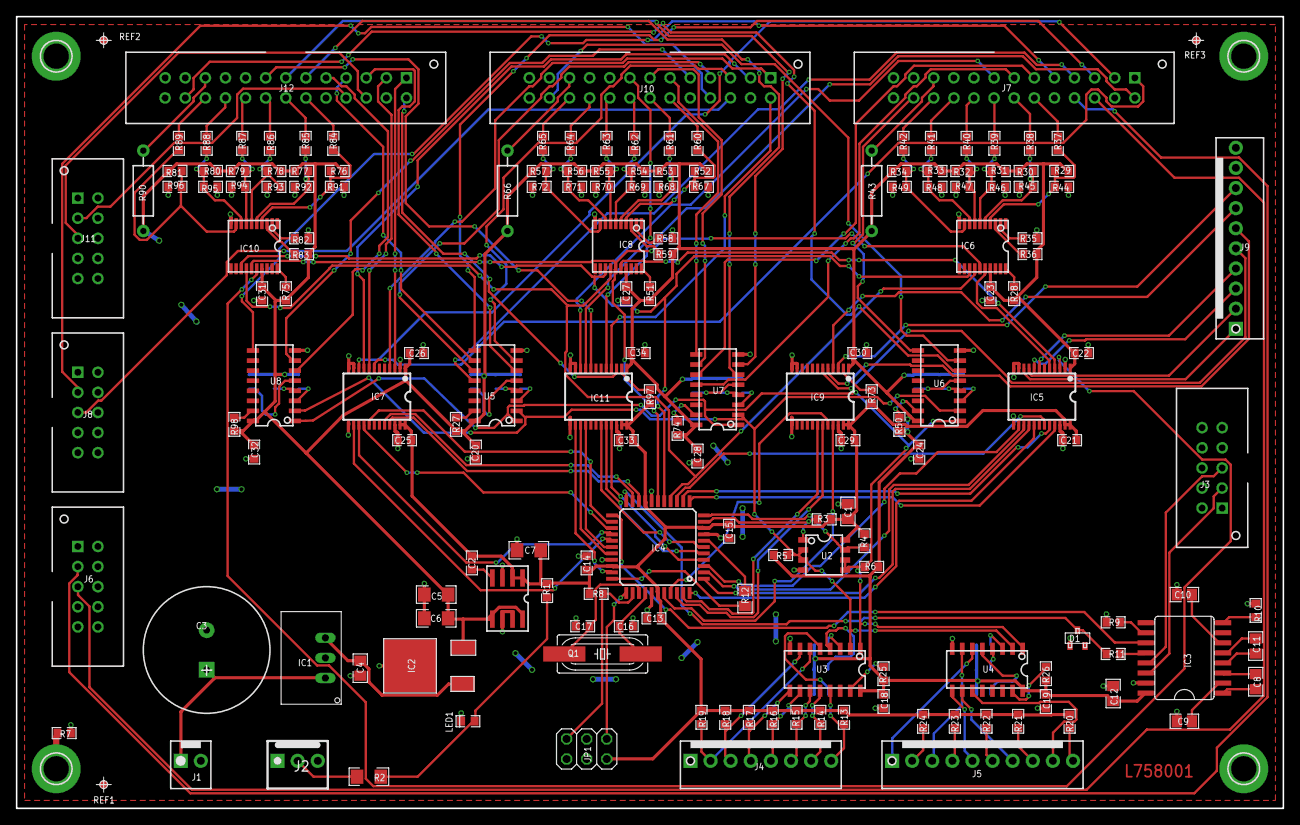
[picture p10: board SCCB1508-00.brd from above]

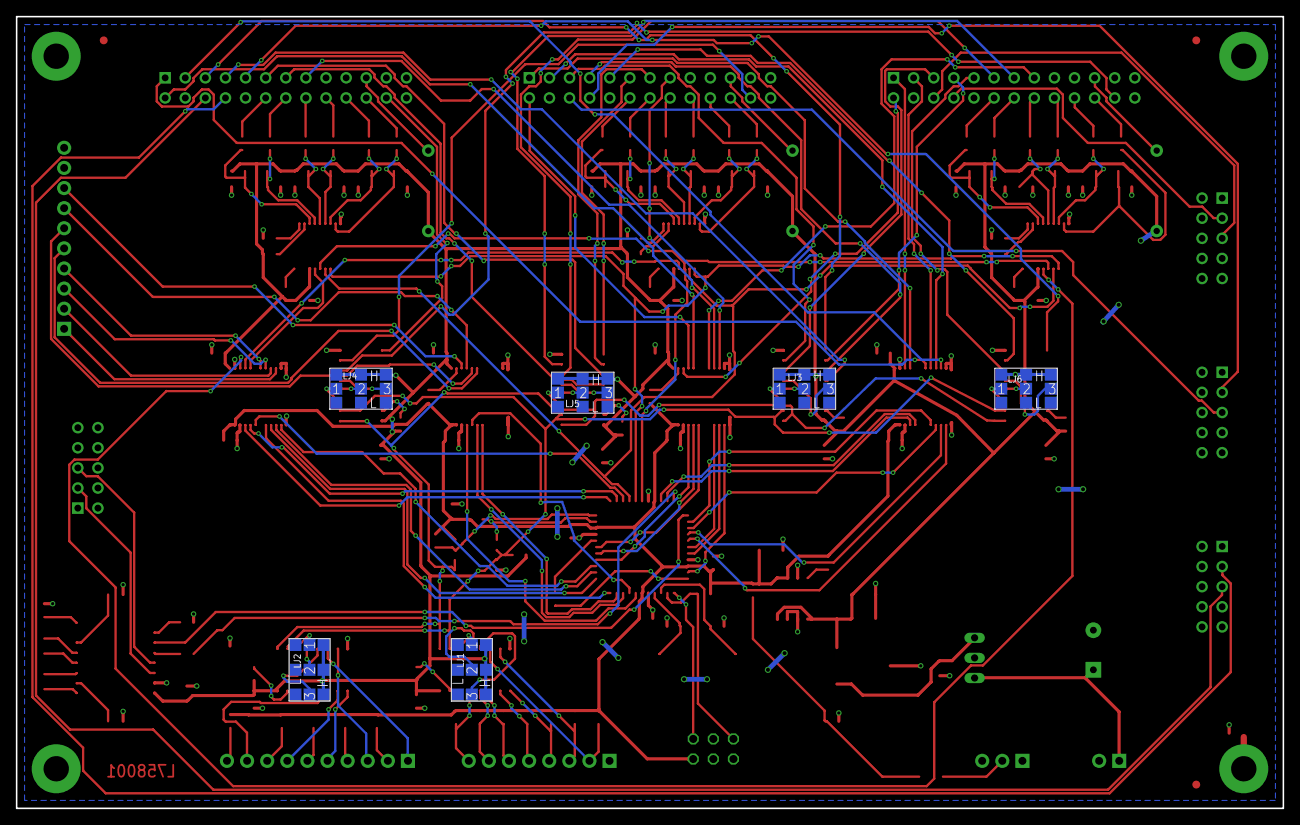
[picture p11: board SCCB1508-00.brd from below]

Board: 2 copper layers, 160.0 x 100.0 mm, 176 parts (6 on the bottom side), 195 nets.
